jaaron/shades-controller/(commit log)

2018-06-01 Add Arduino/NodeMCU sketch for shade controller firmware.
2018-06-01 add OpenSCAD models for housing, ultrasonic sensor, and driver wheel.
    [driver-wheel.scad, housing.scad, motor-top.scad, screwplate-6mm.scad, settings.scad, ultrasonic-sensor-us100.scad]
2018-07-11 modify shades_server to use MQTT (via mosquitto) for all device interactions.
2018-07-11 modify shade controller arduino sketch to use mqtt for server interaction.
2018-07-12 oops, need to actually turn the motor on when target gets set.
2018-07-22 add a section on calibration to README.
2018-07-22 add solar-panel-hook scad file.
    [solar-panel-hook.scad]
2018-07-22 move the chamfer module into settings.scad
    [settings.scad, solar-panel-hook.scad]
2018-07-23 Add a lid for the housing.
    [housing-lid.scad, housing.scad, settings.scad]
2018-07-24 Add housing-lid to README and fix formating a little.
